gyarab/2020-4e-priban-Dron/kod-arduino/README.md

kód pro arduino
_______________
- **dron:** firmware drona. K nahrání na Arduino lze využít například Arduino IDE.
- **PID-tester:** firmware PID testeru.
