gyarab/2020-4e-priban-Dron/3D-modely/README.md

3D modely použité při vývoji
________
- **frame:** rám drona včetně příslušenství jako jsou tlumiče a chrániče propelerů.
- **PID-tester-dron:** PID tester dvouosý.
- **PID-tester-Single_Axis:** PID tester jednoosý.
