gyarab/2020-4e-priban-Dron/Dokumentace/poster.png

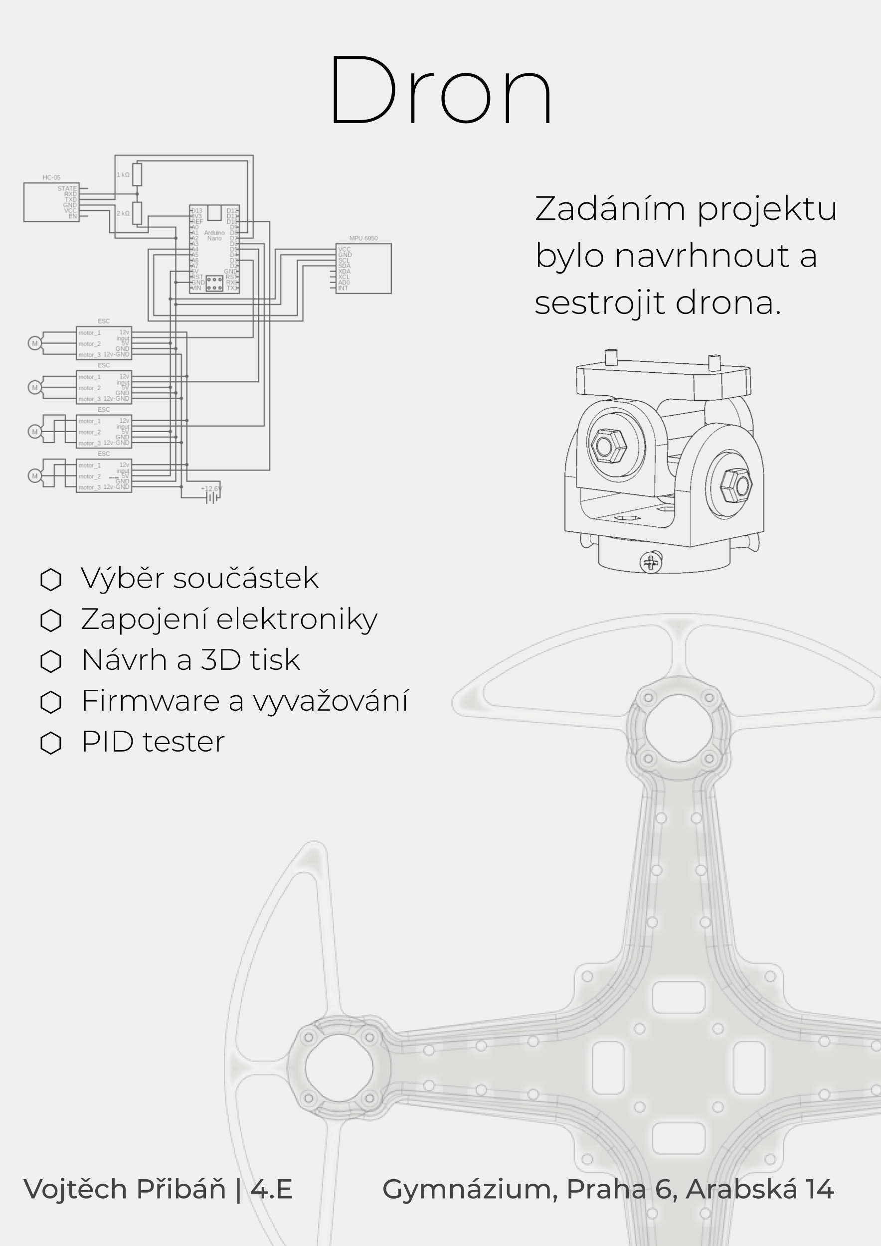
Dokumentace/poster.png
