gyarab/2020-4e-priban-Dron/3D-modely/frame/spodni vrstva.stl

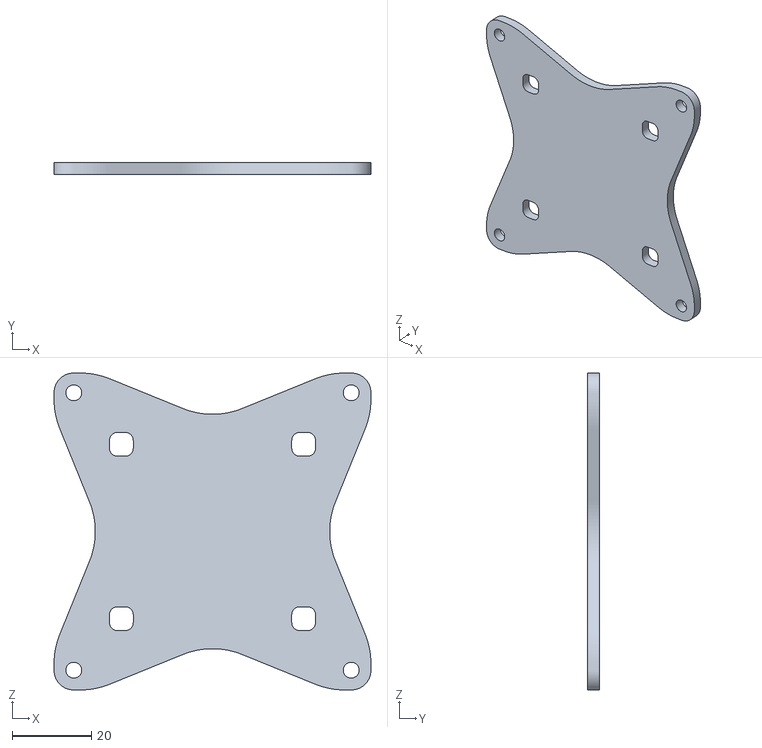
[picture p13: CAD file, 2021-02-01]
3D-modely/frame/spodni vrstva.stl
80.0 x 3.00 x 80.0
