gyarab/2020-4e-priban-Dron/3D-modely/PID-tester-dron/spodni cast drona.stl

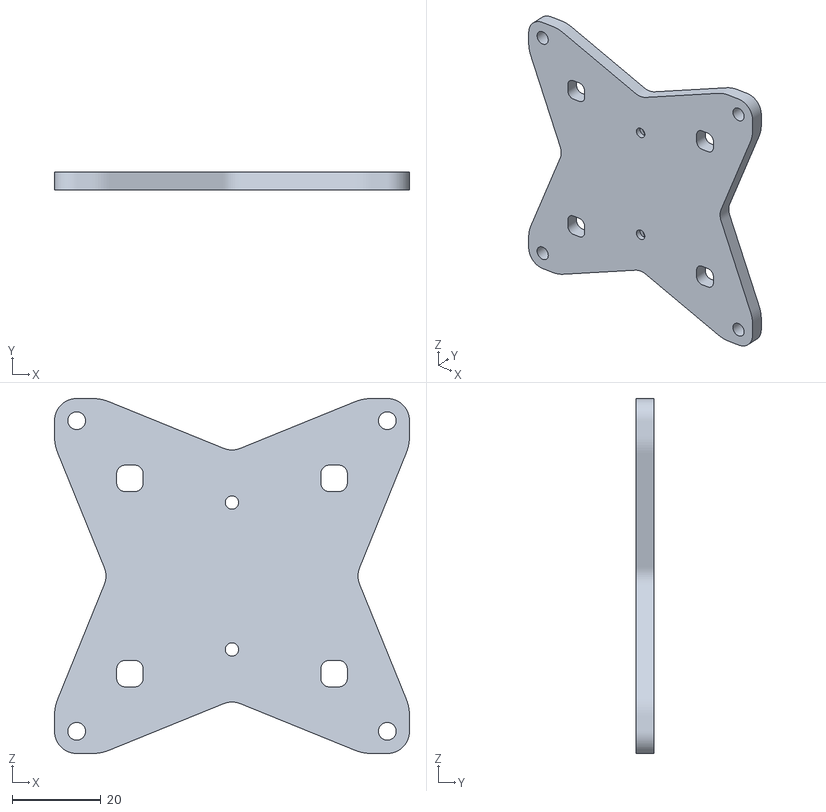
[picture p14: CAD file, 2021-02-01]
3D-modely/PID-tester-dron/spodni cast drona.stl
80.0 x 4.00 x 80.0
