gyarab/2020-4e-priban-Dron/3D-modely/PID-tester-Single_Axis/tlumic.stl

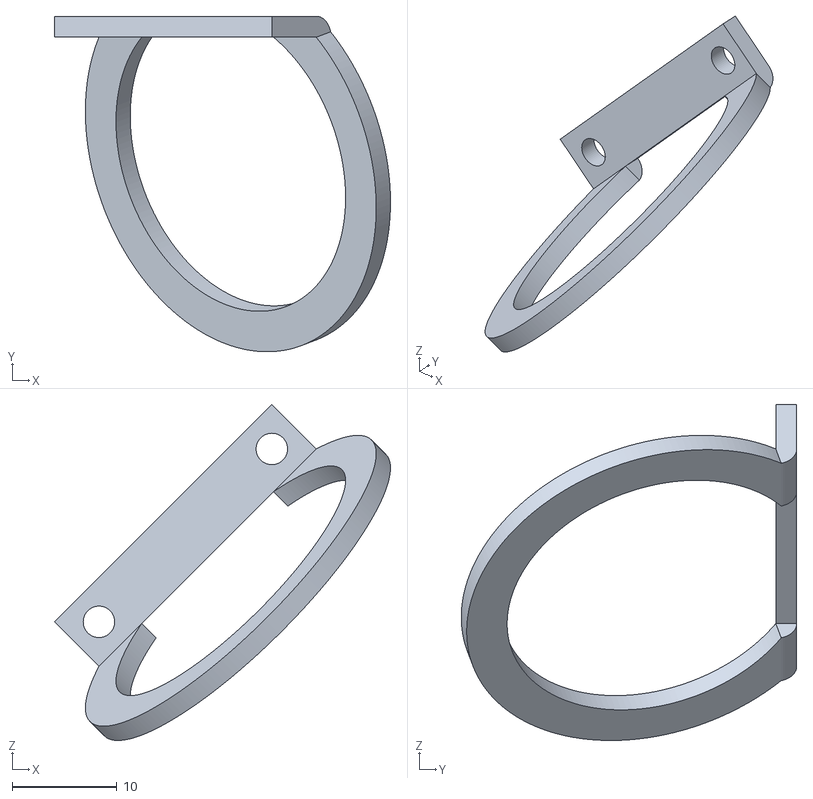
[picture p15: CAD file, 2021-03-08]
3D-modely/PID-tester-Single_Axis/tlumic.stl
32.1 x 32.0 x 32.1
