gyarab/2020-4e-priban-Dron/3D-modely/frame/hlavni telo.stl

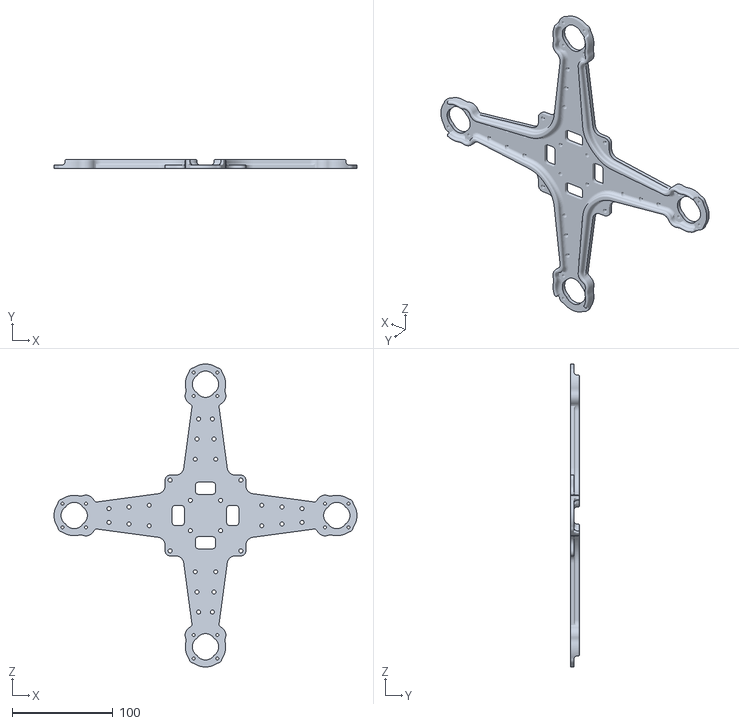
[picture p16: CAD file, 2021-02-01]
3D-modely/frame/hlavni telo.stl
300.0 x 9.00 x 300.0
