gyarab/2020-4e-priban-Dron/3D-modely/PID-tester-dron/sloup.stl

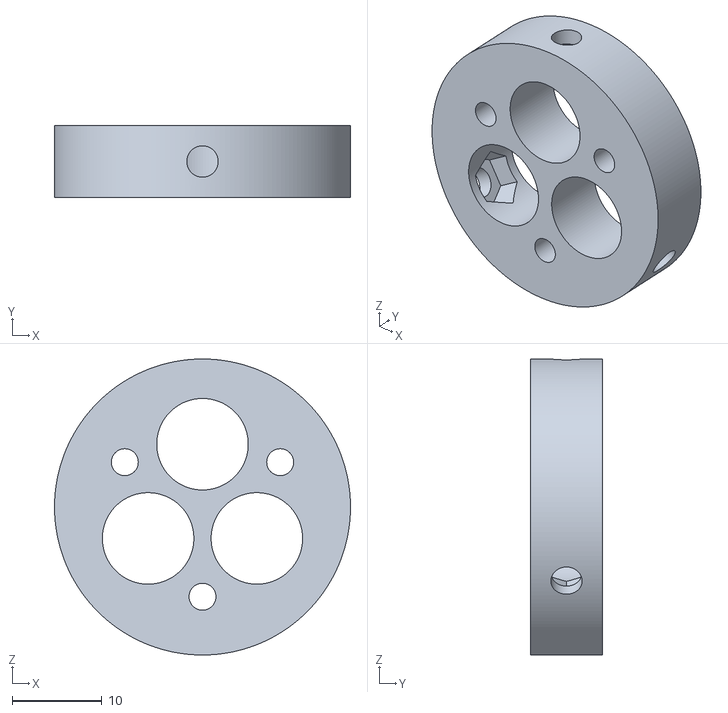
[picture p17: CAD file, 2021-02-01]
3D-modely/PID-tester-dron/sloup.stl
33.0 x 8.00 x 33.0
