gyarab/2020-4e-priban-Dron/3D-modely/PID-tester-Single_Axis/prkno holder.stl

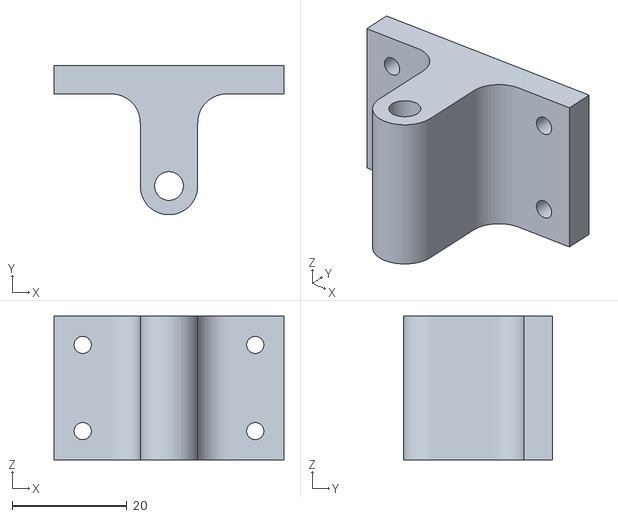
[picture p18: CAD file, 2021-03-08]
3D-modely/PID-tester-Single_Axis/prkno holder.stl
40.0 x 26.0 x 25.0
