gyarab/2020-4e-priban-Dron/3D-modely/frame/prostredni vrstva.stl

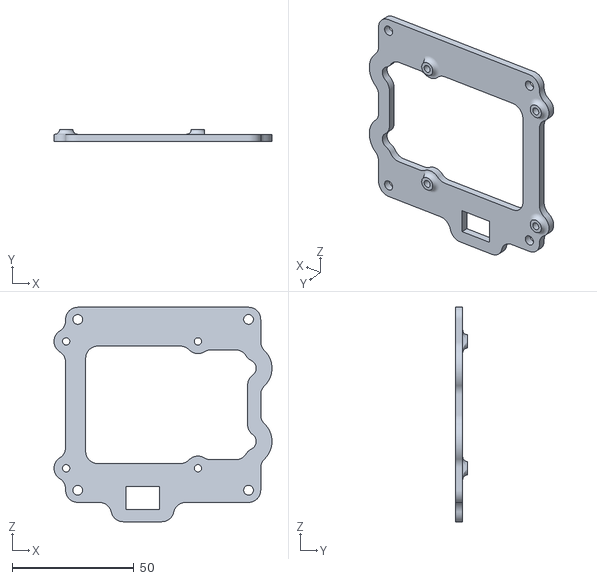
[picture p19: CAD file, 2021-02-01]
3D-modely/frame/prostredni vrstva.stl
89.4 x 5.00 x 87.9
