gyarab/2020-4e-priban-Dron/3D-modely/PID-tester-dron/platforma.stl

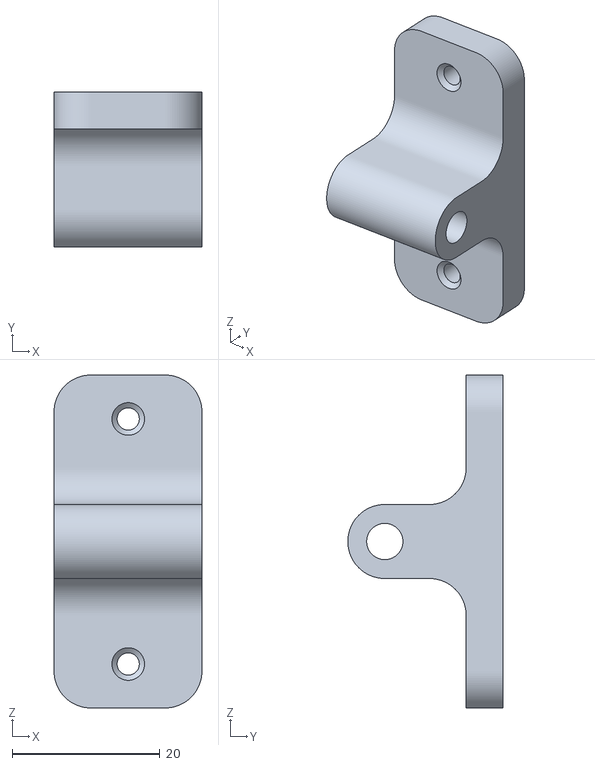
[picture p20: CAD file, 2021-02-01]
3D-modely/PID-tester-dron/platforma.stl
20.0 x 21.0 x 45.0
