gyarab/2020-4e-priban-Dron/3D-modely/PID-tester-Single_Axis/tlumic motor high.stl

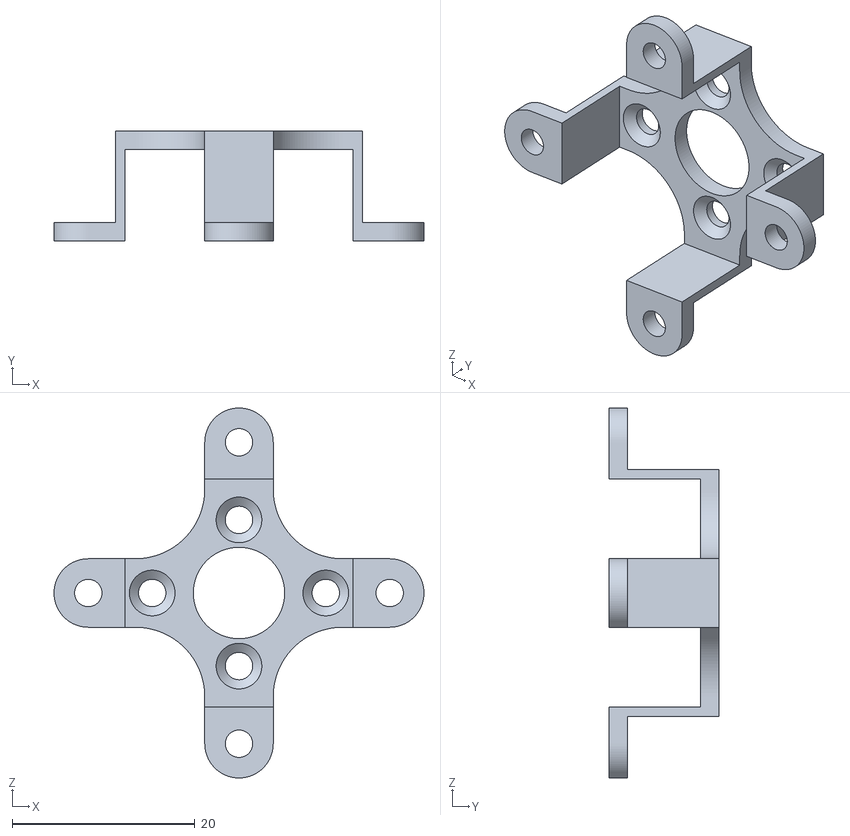
[picture p21: CAD file, 2021-03-08]
3D-modely/PID-tester-Single_Axis/tlumic motor high.stl
40.5 x 12.0 x 40.5
