gyarab/2020-4e-priban-Dron/3D-modely/frame/oddelovac.stl

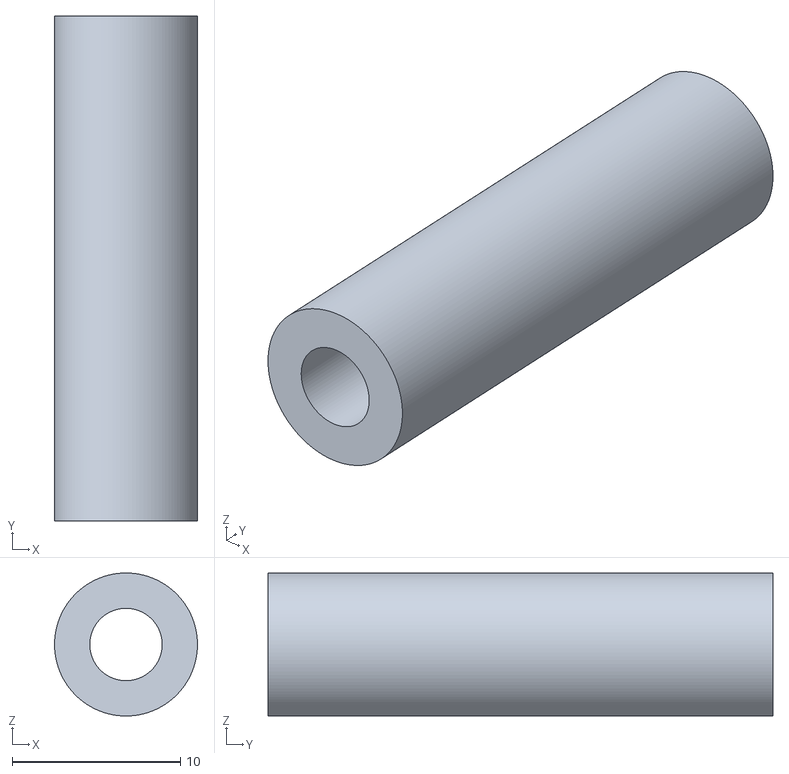
[picture p22: CAD file, 2021-02-01]
3D-modely/frame/oddelovac.stl
8.50 x 30.0 x 8.50
