gyarab/2020-4e-priban-Dron/3D-modely/PID-tester-dron/spodni kloub.stl

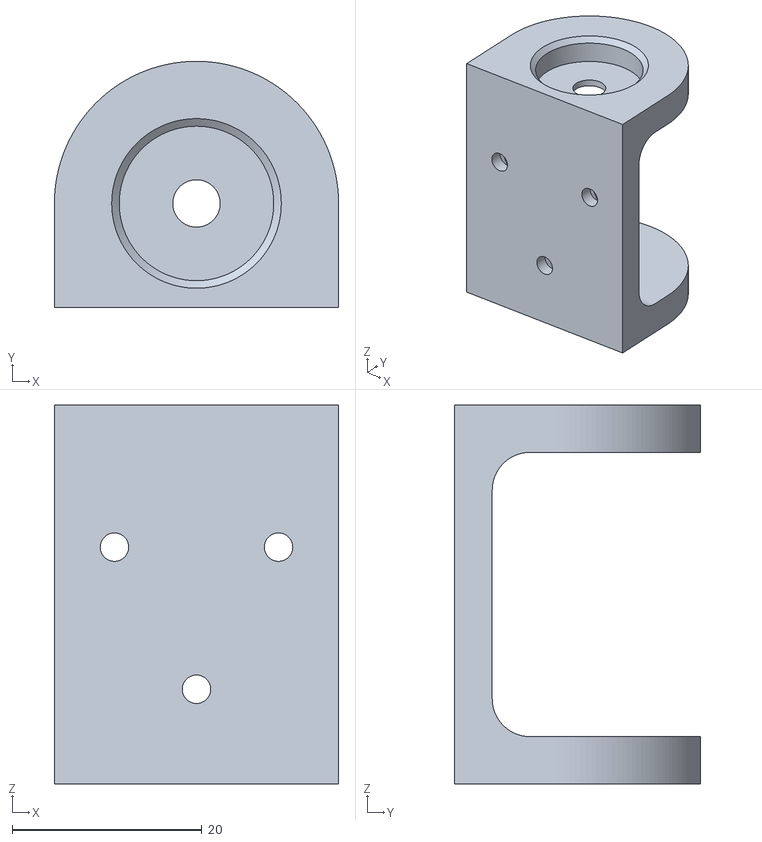
[picture p23: CAD file, 2021-02-01]
3D-modely/PID-tester-dron/spodni kloub.stl
30.0 x 26.0 x 40.0
