gyarab/2020-4e-priban-Dron/3D-modely/PID-tester-Single_Axis/bearing holder.stl

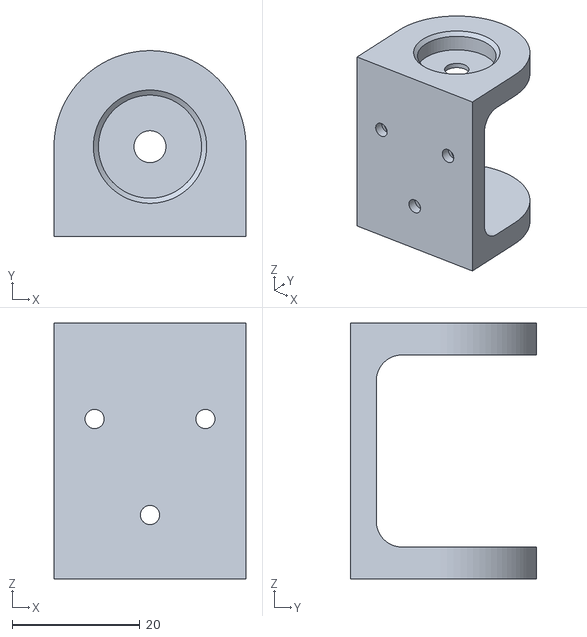
[picture p24: CAD file, 2021-03-08]
3D-modely/PID-tester-Single_Axis/bearing holder.stl
30.0 x 29.0 x 40.0
