gyarab/2020-4e-priban-Dron/3D-modely/frame/ochrana vrtulek.stl

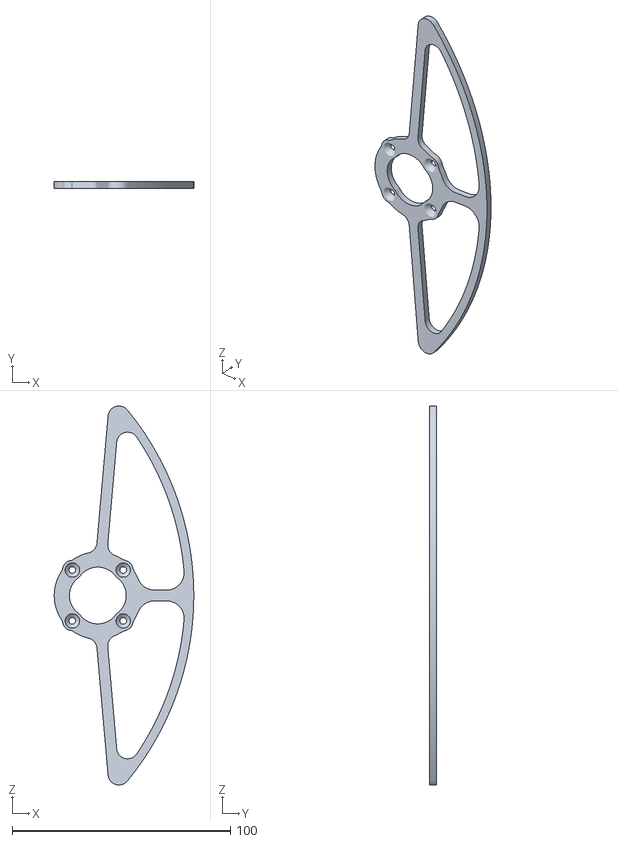
[picture p25: CAD file, 2021-02-01]
3D-modely/frame/ochrana vrtulek.stl
64.0 x 3.00 x 173.8
