gyarab/2020-4e-priban-Dron/3D-modely/PID-tester-dron/horni uchyt.stl

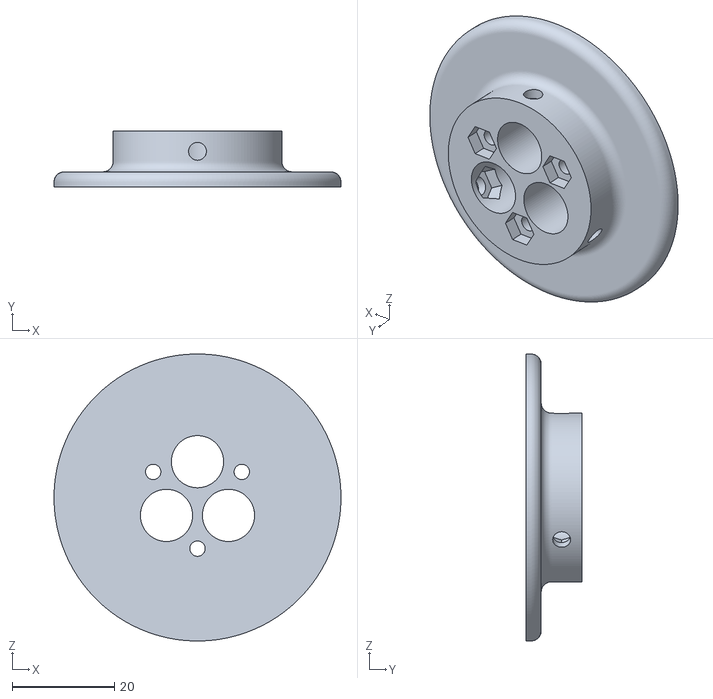
[picture p26: CAD file, 2021-02-01]
3D-modely/PID-tester-dron/horni uchyt.stl
56.1 x 11.0 x 56.1
