gyarab/2020-4e-priban-Dron/3D-modely/PID-tester-dron/spodni uchyt.stl

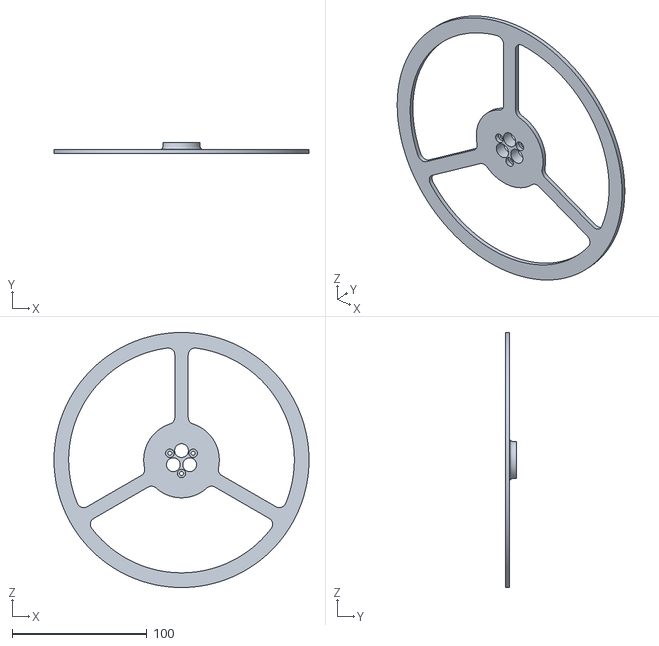
[picture p27: CAD file, 2021-02-01]
3D-modely/PID-tester-dron/spodni uchyt.stl
189.2 x 8.00 x 189.2
