gyarab/2020-4e-priban-Dron/3D-modely/PID-tester-dron/horni kloub.stl

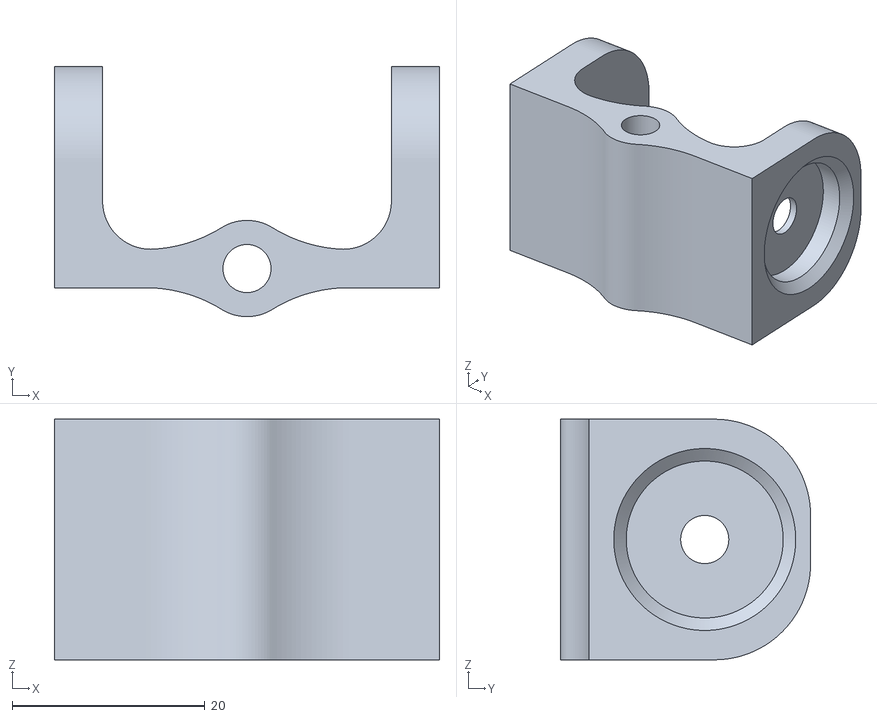
[picture p28: CAD file, 2021-02-01]
3D-modely/PID-tester-dron/horni kloub.stl
40.0 x 26.0 x 25.0
