gyarab/2020-4e-priban-Dron/3D-modely/PID-tester-Single_Axis/README.MD

3D modely užité při sestavování PId testeru pro ladění hodnot PID v jednom úhlu.
