gyarab/2020-4e-priban-Dron/kod-arduino/PID-tester/README.MD

tento kód je upravený firmweare drona pro ovládání pid testeru.
Pid tester je zařízení sloužící k ladění pid hodnot. Vyvažuje se pouze v jedné ose.
