gyarab/2020-4e-priban-Dron/3D-modely/PID-tester-dron/README.md

3D modely potřebné k sestavení PID testeru
